tylerebowers/CosmicMouse/cad/fea/backwards_fea.png

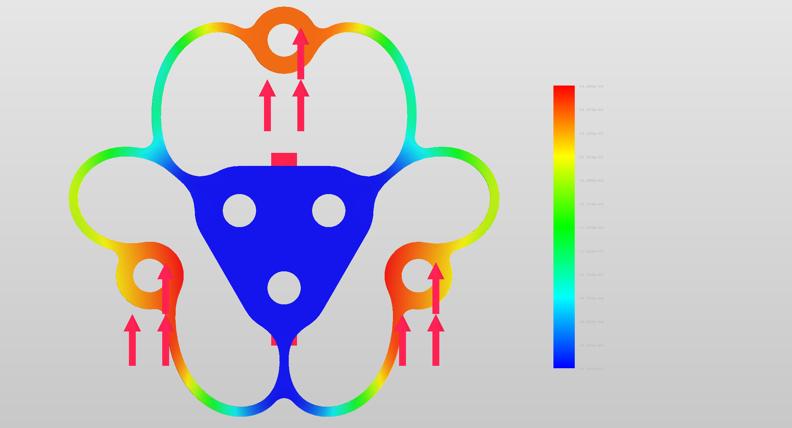
cad/fea/backwards_fea.png
