tylerebowers/CosmicMouse/cad/fea/downwards_fea.png

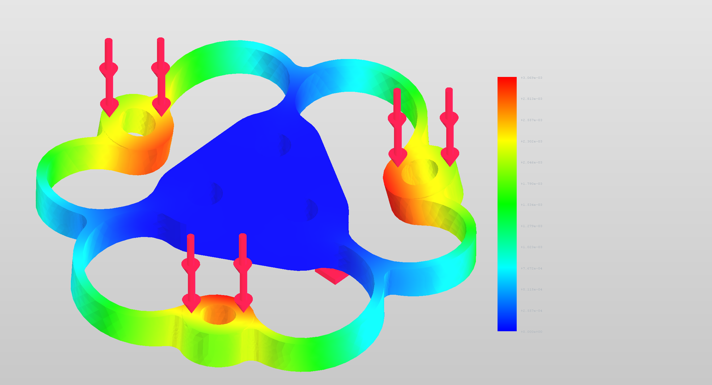
cad/fea/downwards_fea.png
