tylerebowers/CosmicMouse/cad/fea/downwards_stress_fea.png

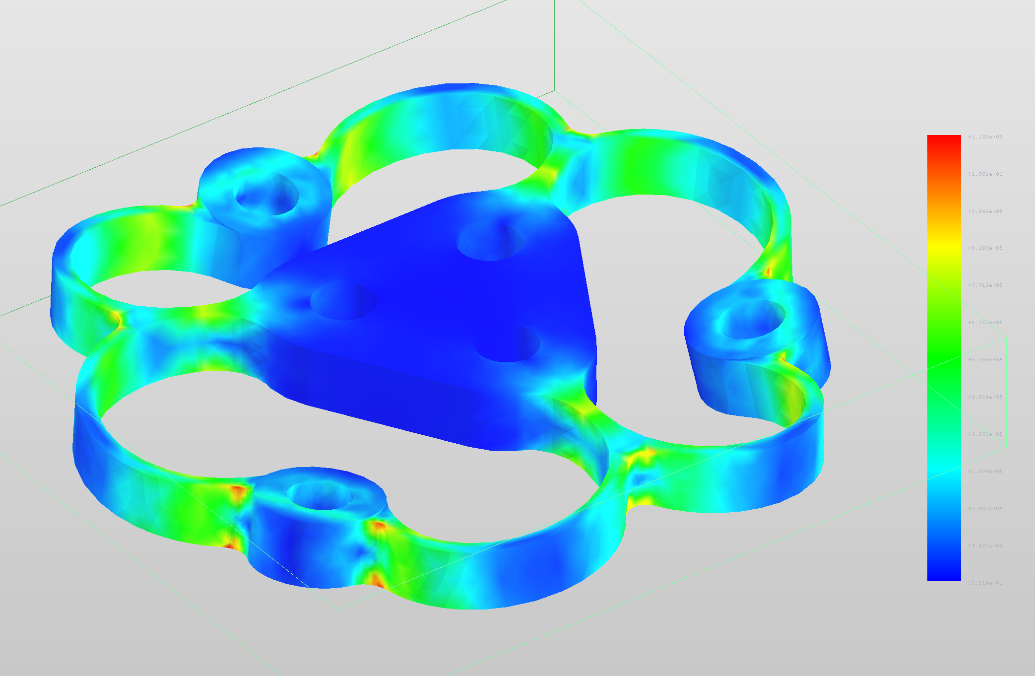
cad/fea/downwards_stress_fea.png
