tylerebowers/CosmicMouse/cad/fea/forwards_fea.png

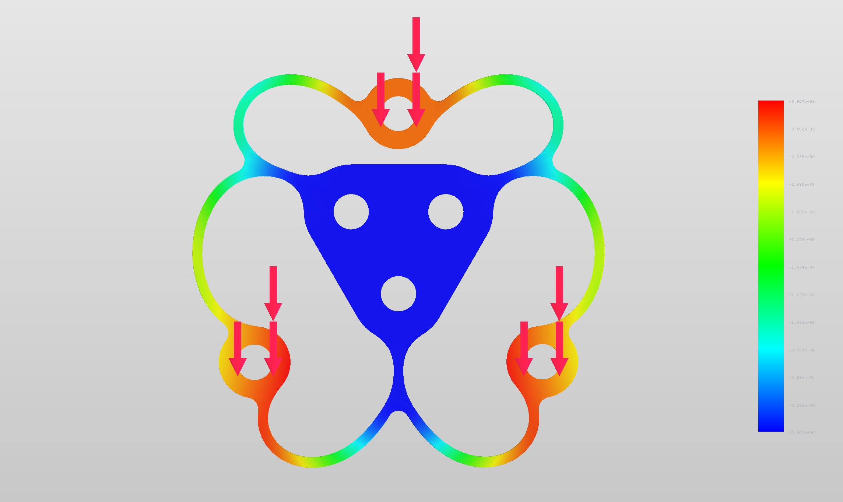
cad/fea/forwards_fea.png
