tylerebowers/CosmicMouse/cad/fea/right_fea.png

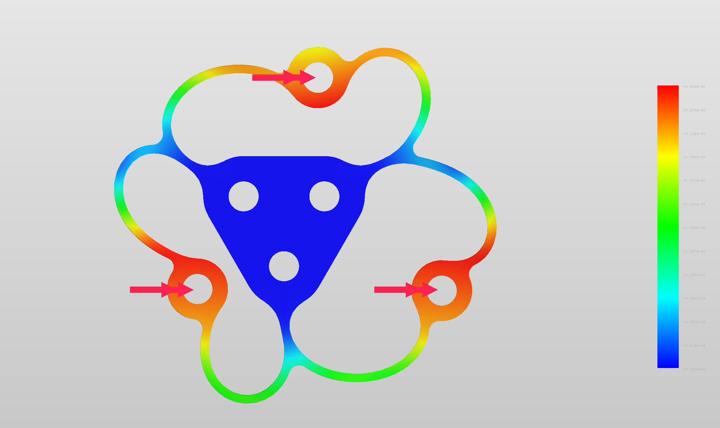
cad/fea/right_fea.png
