tylerebowers/CosmicMouse/cad/fea/rotate_fea.png

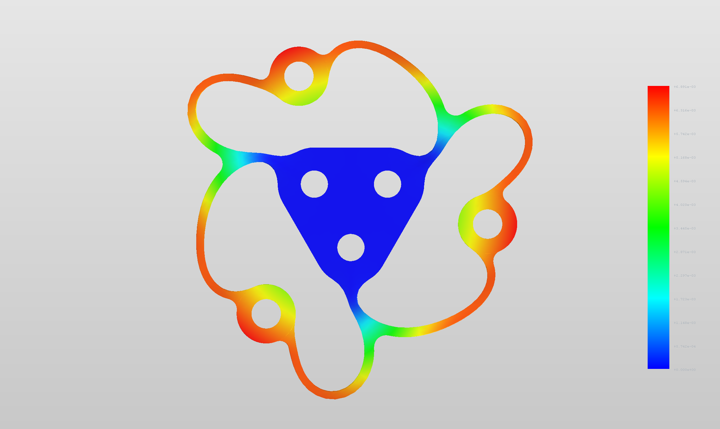
cad/fea/rotate_fea.png
