tylerebowers/CosmicMouse/media/Screenshot_20261007_221154.png

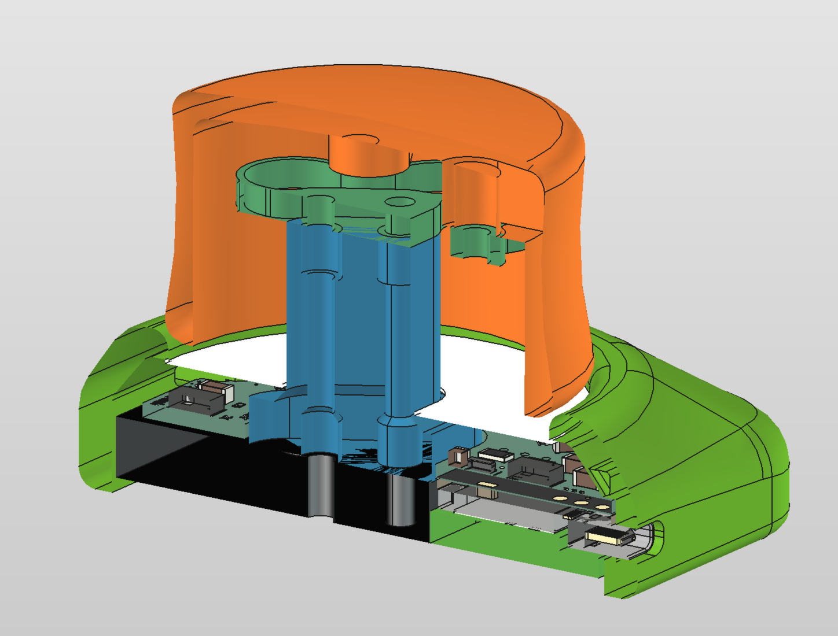
media/Screenshot_20261007_221154.png
