tylerebowers/CosmicMouse/pcb/bom.csv

Reference | Qty | Value | Footprint | Datasheet
C1,C2,C3,C4,C5,C6,C7,C8,C10,C11,C12,C13 | 12 | 100nf | PCM_JLCPCB:C_1206
C9,C14 | 2 | 10uf | PCM_JLCPCB:C_1206
LED1,LED2,LED3,LED4,LED5,LED6,LED7,LED8 | 8 | IN-PI55TATPRPGPB | space_mouse:LED_IN-PI55TAT_INL | IN-PI55TATPRPGPB
R1,R2 | 2 | 4.7k | PCM_JLCPCB:R_1206
R3 | 1 | 220 | PCM_JLCPCB:R_1206
SW1,SW2 | 2 | EVQ-P7J01P | space_mouse:SW_EVQ-P7J01P
U1 | 1 | SN74AHCT1G125DBVR | space_mouse:DBV5 | https://www.ti.com/lit/gpn/sn74ahct1g125
U2 | 1 | XIAO-RP2350-DIP | Seeed_Studio_XIAO_Series:XIAO-RP2350-DIP
U3 | 1 | TMAG5273A1QDBVR | space_mouse:DBV0006A-IPC_A | https://www.ti.com/lit/gpn/tmag5273
U4 | 1 | TMAG5273B1QDBVR | space_mouse:DBV0006A-IPC_A | https://www.ti.com/lit/gpn/tmag5273
U5 | 1 | TMAG5273C1QDBVR | space_mouse:DBV0006A-IPC_A | https://www.ti.com/lit/gpn/tmag5273
