tylerebowers/CosmicMouse/pcb/pcbway_production/2026-09-30-13-18-18/pcb.kicad_pcb_bom.csv

Designator | Quantity | Value | Footprint | Package | MPN | DNP | Mount_Type
C1, C10, C11, C12, C13, C14, C2, C3, C4, C5, C6, C7, C8, C9 | 14 | C_1206_3216Metric | C_1206 |  |  |  | smt
LED1, LED2, LED3, LED4, LED5, LED6, LED7, LED8 | 8 | LED_IN-PI55TAT_INL | LED_IN-PI55TAT_INL |  |  |  | smt
R1, R2, R3 | 3 | R_1206_3216Metric | R_1206 |  |  |  | smt
SW1, SW2 | 2 | SW_EVQ-P7J01P | SW_EVQ-P7J01P |  |  |  | smt
U1 | 1 | DBV5 | DBV5 |  |  |  | smt
U2 | 1 | XIAO-RP2350-DIP | XIAO-RP2350-DIP |  |  |  | smt
U3, U4, U5 | 3 | DBV0006A-IPC_A | DBV0006A-IPC_A |  |  |  | smt
