tylerebowers/CosmicMouse/cad/mouse.FCStd

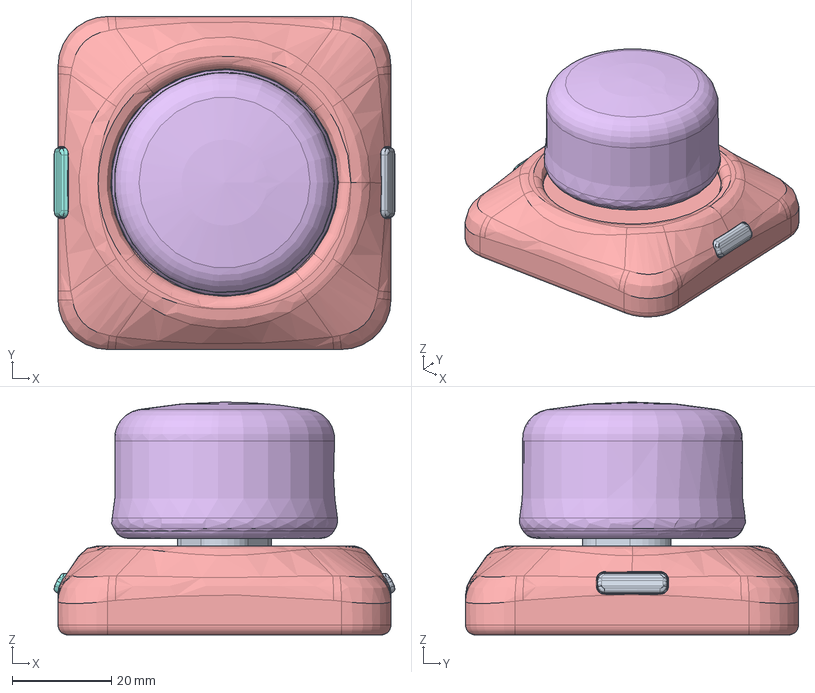
[picture p12: CAD file, 2026-10-30]
cad/mouse.FCStd
68.8 x 67.2 x 47.0 mm
knob shaft
EVQ-P7J01P
EVQ-P7J01P001
EVQ-P7J01P002
EVQ-P7J01P003
EVQ-P7J01P004
EVQ-P7J01P005
EVQ-P7J01P006
C_1206_3216Metric
C_1206_3216Metric001
C_1206_3216Metric002
R_1206_3216Metric
BODY-SOT
LEAD-SOT
LEAD-SOT001
LEAD-SOT002
LEAD-SOT003
LEAD-SOT004
LEAD-SOT005
C_1206_3216Metric003
C_1206_3216Metric004
BODY-SOT001
LEAD-SOT006
LEAD-SOT007
LEAD-SOT008
LEAD-SOT009
LEAD-SOT010
LEAD-SOT011
C_1206_3216Metric005
C_1206_3216Metric006
C_1206_3216Metric007
C_1206_3216Metric008
C_1206_3216Metric009
EVQ-P7J01P010
EVQ-P7J01P011
EVQ-P7J01P012
EVQ-P7J01P013
EVQ-P7J01P014
EVQ-P7J01P015
EVQ-P7J01P016
BODY-SOT002
LEAD-SOT012
LEAD-SOT013
LEAD-SOT014
LEAD-SOT015
LEAD-SOT016
LEAD-DUMMY
BODY-SOT003
LEAD-SOT017
LEAD-SOT018
LEAD-SOT019
LEAD-SOT020
LEAD-SOT021
LEAD-SOT022
C_1206_3216Metric010
C_1206_3216Metric011
C_1206_3216Metric012
C_1206_3216Metric013
R_1206_3216Metric001
R_1206_3216Metric002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
