tylerebowers/CosmicMouse/cad/out/mouse-base.stl

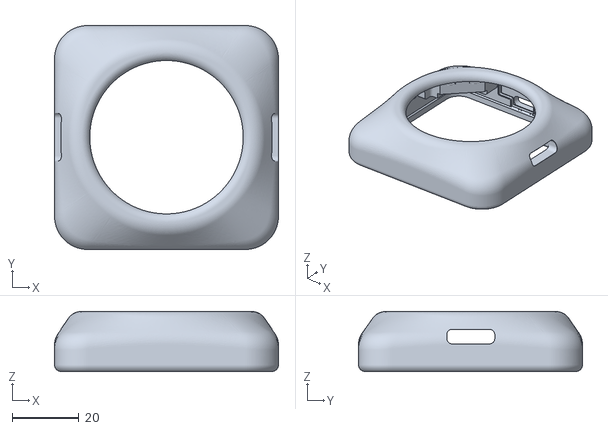
[picture p13: CAD file, 2026-10-30]
cad/out/mouse-base.stl
67.2 x 67.2 x 18.0
