tylerebowers/CosmicMouse/pcb/pcb.step

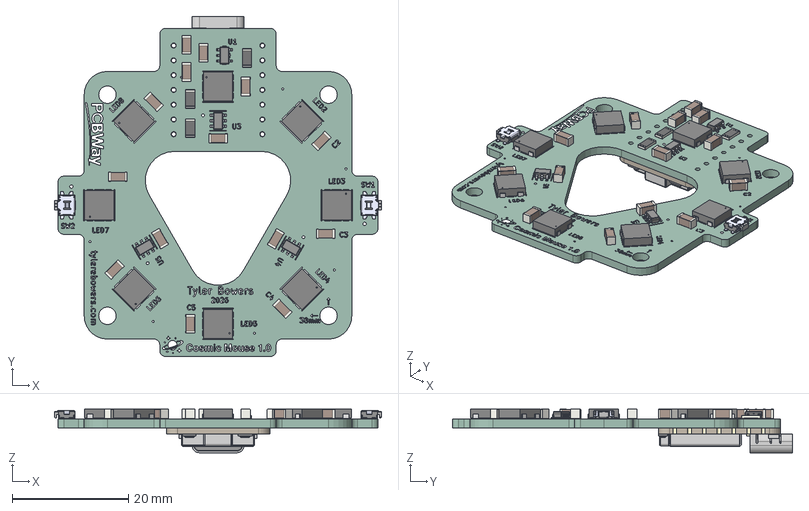
[picture p15: CAD file, 2026-10-07]
pcb/pcb.step
56.2 x 58.4 x 7.49 mm
EVQ-P7J01P x 2
C_1206_3216Metric x 14
R_1206_3216Metric x 3
BODY-SOT x 4
LEAD-SOT x 23
LEAD-DUMMY
BOSS-EXTRUDE14_8_
BOSS-EXTRUDE7_4_
BOSS-EXTRUDE7_3_
BOSS-EXTRUDE14_4_
BOSS-EXTRUDE14_2_
BOSS-EXTRUDE14_11_
BOSS-EXTRUDE7_7_
BOSS-EXTRUDE14_9_
BOSS-EXTRUDE14_3_
BOSS-EXTRUDE14_7_
MIRROR2
BOSS-EXTRUDE14_5_
BOSS-EXTRUDE14_12_
BOSS-EXTRUDE7_8_
BOSS-EXTRUDE7_1_
BOSS-EXTRUDE14_10_
BOSS-EXTRUDE7_9_
BOSS-EXTRUDE14_6_
BOSS-EXTRUDE14_1_
BOSS-EXTRUDE7_6_
BOSS-EXTRUDE7_2_
CUT-EXTRUDE5
BOSS-EXTRUDE7_5_
Shield
pcb_silkscreen x 2
pcb_PCB
