tylerebowers/CosmicMouse/cad/out/mouse-knob shaft.stl

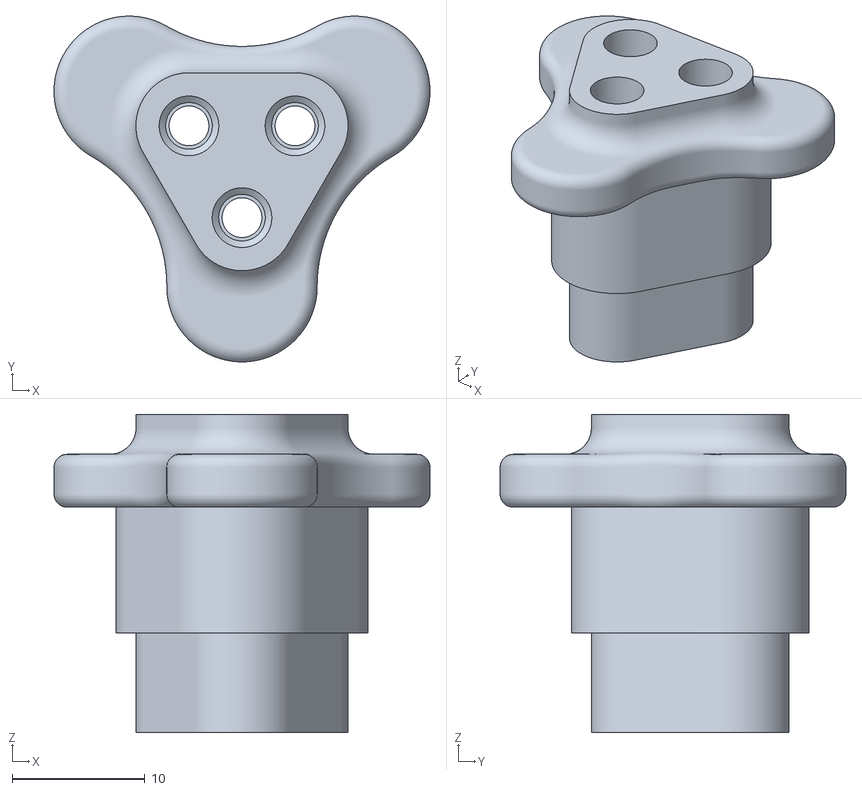
[picture p16: CAD file, 2026-10-30]
cad/out/mouse-knob shaft.stl
28.4 x 26.1 x 24.0
