tylerebowers/CosmicMouse/pcb/3d/LED_IN-PI55TAT_INL.step

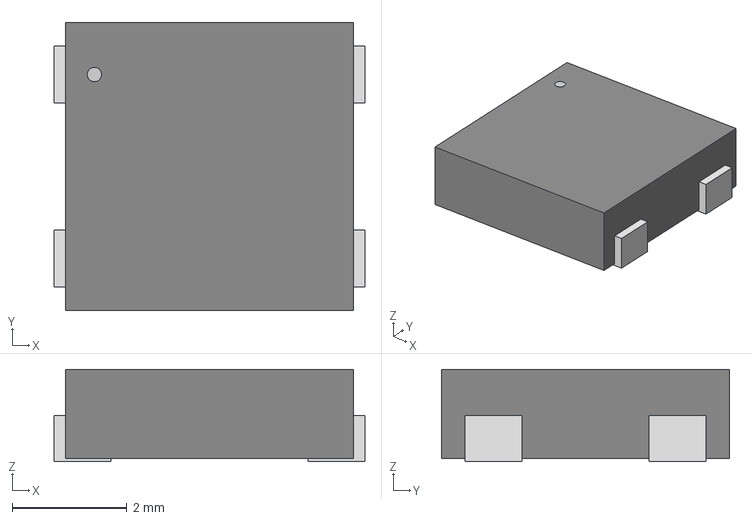
[picture p17: CAD file, 2026-10-07]
pcb/3d/LED_IN-PI55TAT_INL.step
5.41 x 5.00 x 1.60 mm
