tylerebowers/CosmicMouse/cad/out/mouse-diffuser.stl

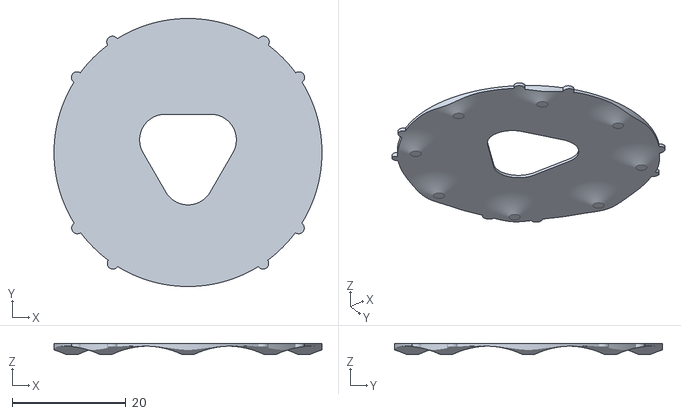
[picture p18: CAD file, 2026-10-30]
cad/out/mouse-diffuser.stl
47.1 x 47.1 x 2.00
