tylerebowers/CosmicMouse/cad/out/mouse-button.stl

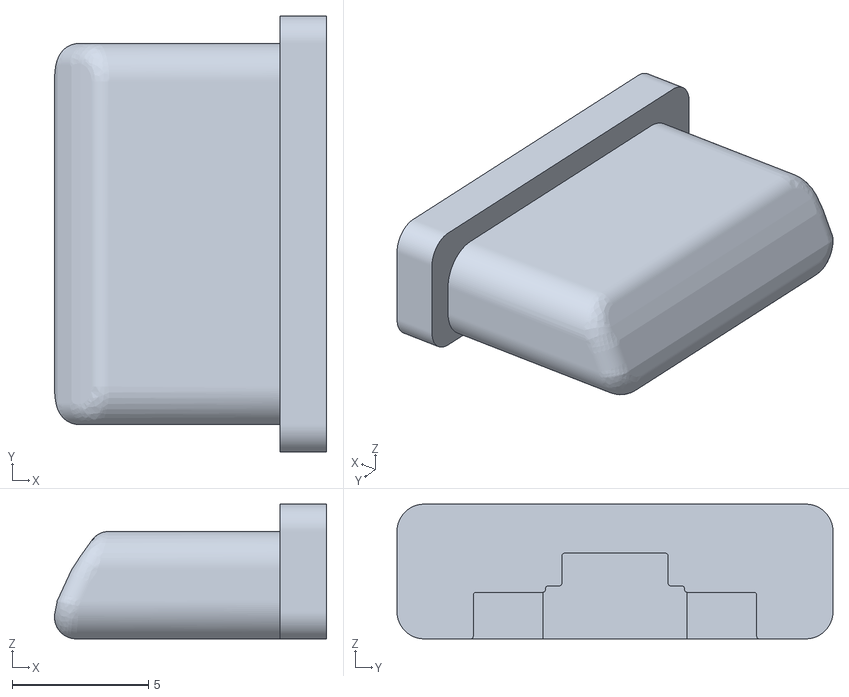
[picture p19: CAD file, 2026-10-30]
cad/out/mouse-button.stl
9.99 x 16.0 x 4.94
