tylerebowers/CosmicMouse/cad/out/mouse-spring.stl

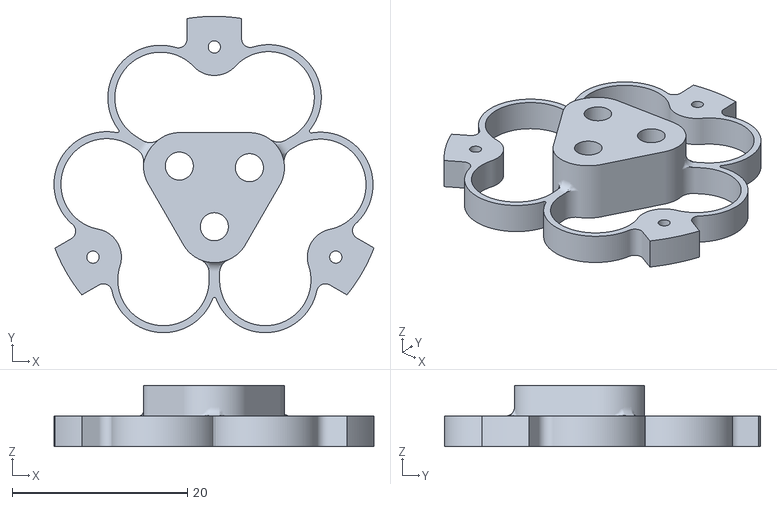
[picture p20: CAD file, 2026-10-30]
cad/out/mouse-spring.stl
36.5 x 36.1 x 7.00
