tylerebowers/CosmicMouse/cad/out/mouse-knob.stl

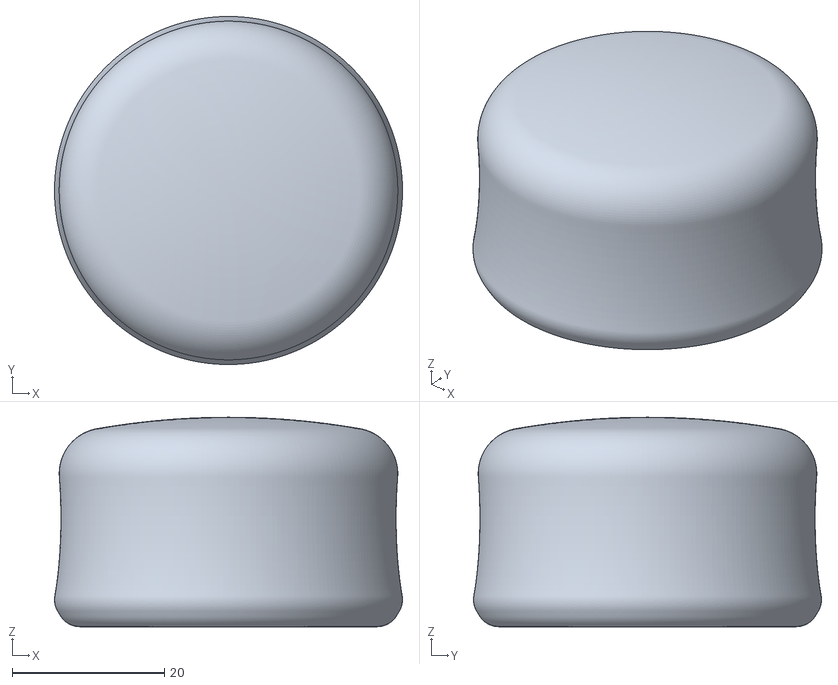
[picture p21: CAD file, 2026-10-30]
cad/out/mouse-knob.stl
45.7 x 45.7 x 27.5
