tylerebowers/CosmicMouse/cad/out/mouse-weight filler.stl

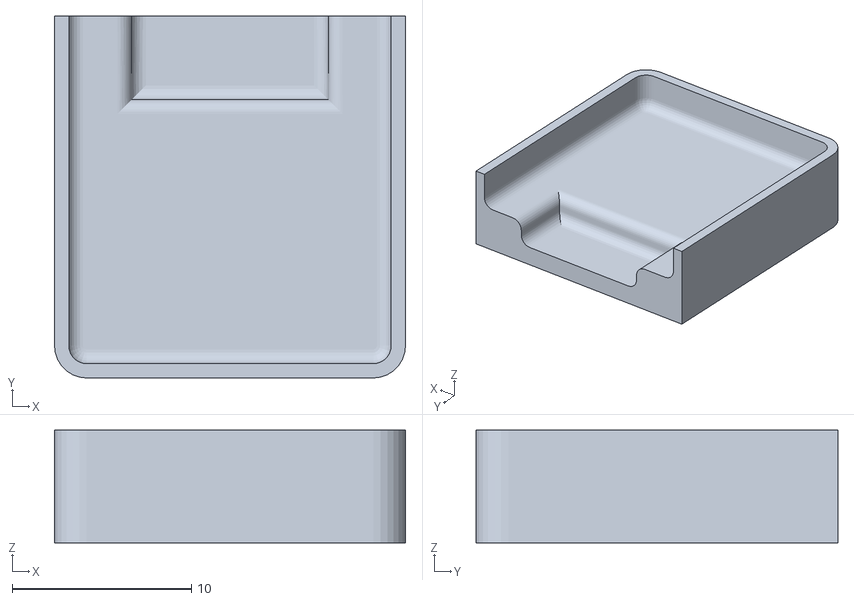
[picture p22: CAD file, 2026-10-21]
cad/out/mouse-weight filler.stl
19.6 x 20.2 x 6.30
