tylerebowers/CosmicMouse/cad/out/mouse-rubber_for_stencil.stl

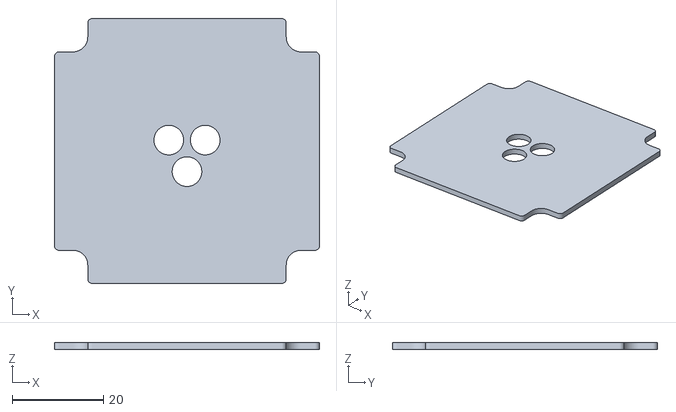
[picture p23: CAD file, 2026-10-21]
cad/out/mouse-rubber_for_stencil.stl
58.2 x 58.2 x 1.50
