tylerebowers/CosmicMouse/cad/out/mouse-base weight.stl

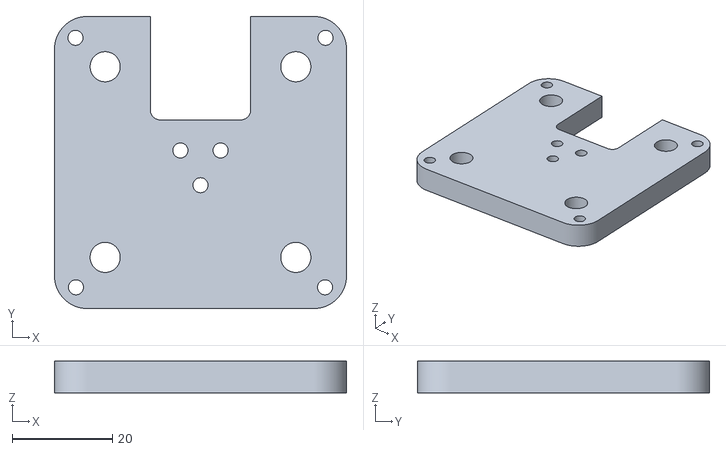
[picture p24: CAD file, 2026-10-07]
cad/out/mouse-base weight.stl
58.2 x 58.2 x 6.35
