tylerebowers/CosmicMouse/cad/out/mouse-knob-v2.stl

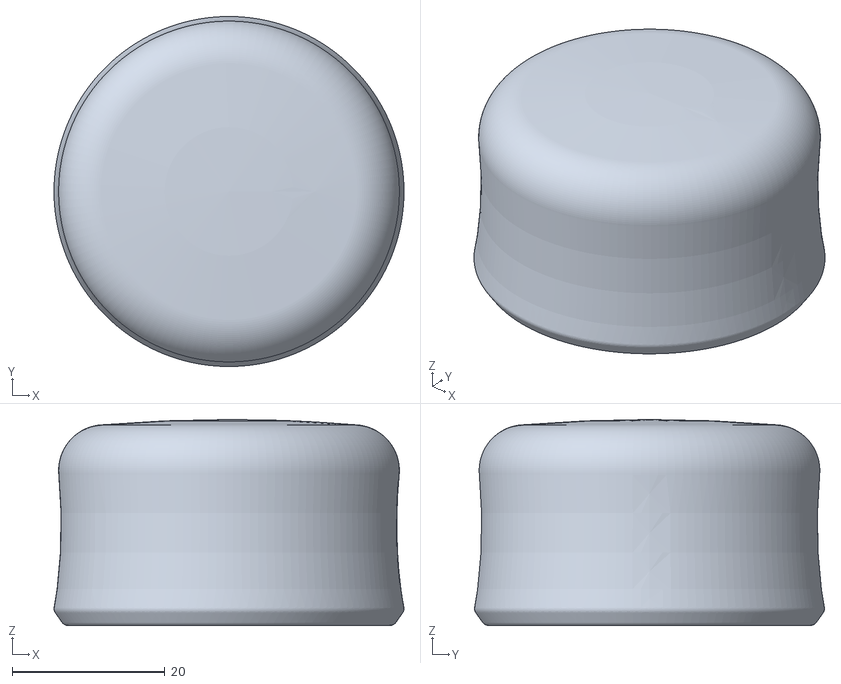
[picture p25: CAD file, 2026-10-21, an earlier design]
cad/out/mouse-knob-v2.stl
45.9 x 45.9 x 27.0
