tylerebowers/CosmicMouse/(list of files, cad)

Other CAD files:
cad/out/mouse-base weight.dxf
cad/out/mouse-knob_shaft.stl
