tylerebowers/CosmicMouse/pcb/pcb.kicad_pcb

## KiCad design pcb/pcb.kicad_pcb (2026-10-30)

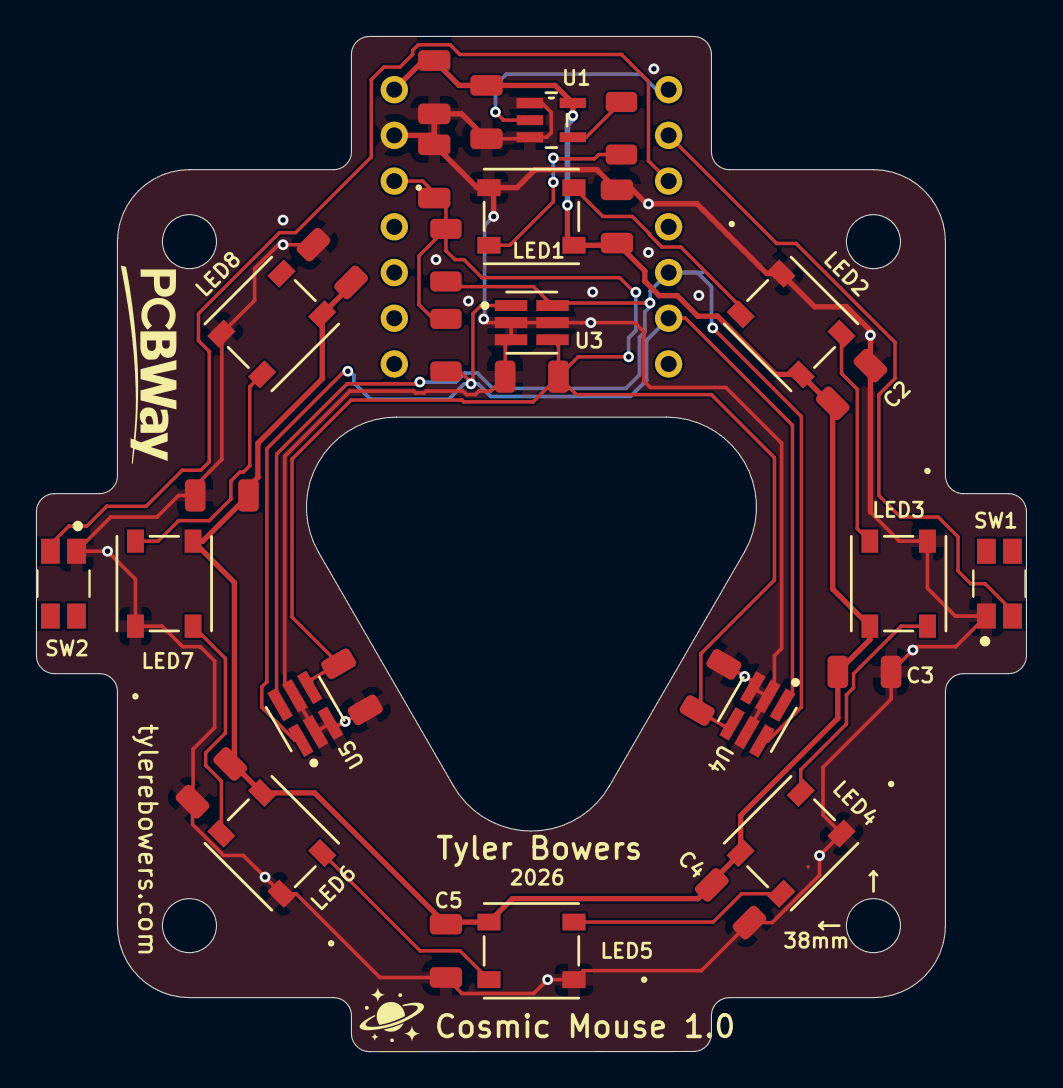
[picture p26: board pcb.kicad_pcb from above]

Board: 2 copper layers, 55.0 x 56.4 mm, 32 parts (1 on the bottom side), 17 nets.

Parts:
C1, C2, C3, C4, C5, C6, C7, C8, C9, C10, C11, C12, C13, C14: C_1206_3216Metric; C_1206
LED1, LED2, LED3, LED4, LED5, LED6, LED7, LED8: LED_IN-PI55TAT_INL
R1, R2, R3: R_1206_3216Metric; R_1206
SW1, SW2: SW_EVQ-P7J01P
U1: DBV5
U2: XIAO-RP2350-DIP
U3, U4, U5: DBV0006A-IPC_A

Connections:
+3.3V: C10.2, C11.2, C12.2, C14.2, R1.2, R2.2, U2.12, U3.4, U4.4, U5.4
+5V: C1.1, C2.1, C3.1, C4.1, C5.1, C6.1, C7.1, C8.1, C9.1, C13.1, LED1.4, LED2.4, LED3.4, LED4.4, LED5.4, LED6.4, LED7.4, LED8.4, U1.5, U2.14
D1_mc: SW1.2_1, U2.2
D2_mc: SW2.2_1, U2.3
GND: C1.2, C2.2, C3.2, C4.2, C5.2, C6.2, C7.2, C8.2, C9.2, C10.1, C11.1, C12.1, C13.2, C14.1, LED1.1, LED2.1, LED3.1, LED4.1, LED5.1, LED6.1, LED7.1, LED8.1, SW1.1_1, SW2.1_1, U1.1, U1.3, U2.13, U3.2, U3.3, U3.5, U4.2, U4.3, U4.5, U5.2, U5.3, U5.5
unnamed: LED1.3, R3.1
unnamed: LED1.2, LED2.3
unnamed: LED2.2, LED3.3
unnamed: LED3.2, LED4.3
unnamed: LED4.2, LED5.3
unnamed: LED5.2, LED6.3
unnamed: LED6.2, LED7.3
unnamed: LED7.2, LED8.3
unnamed: U1.2, U2.1
unnamed: R3.2, U1.4
unnamed: R1.1, U2.5, U3.6, U4.6, U5.6
unnamed: R2.1, U2.6, U3.1, U4.1, U5.1
