tylerebowers/CosmicMouse/(commit log)

2026-10-21 test firmware and cad revisions (going to change further)
2026-10-22 Add cad
2026-10-23 Update cad
2026-10-26 some math + minor cad changes
2026-10-29 cad work, prep firmware
2026-10-30 cad; firmware wip
2026-10-30 Add pcb pics
2026-10-30 BOM correction
2026-10-30 Correct spring image
2026-10-30 Block calibration button press movement
